jpwolfe9912/F722-FC-V3/PNGs/3D_Front.png

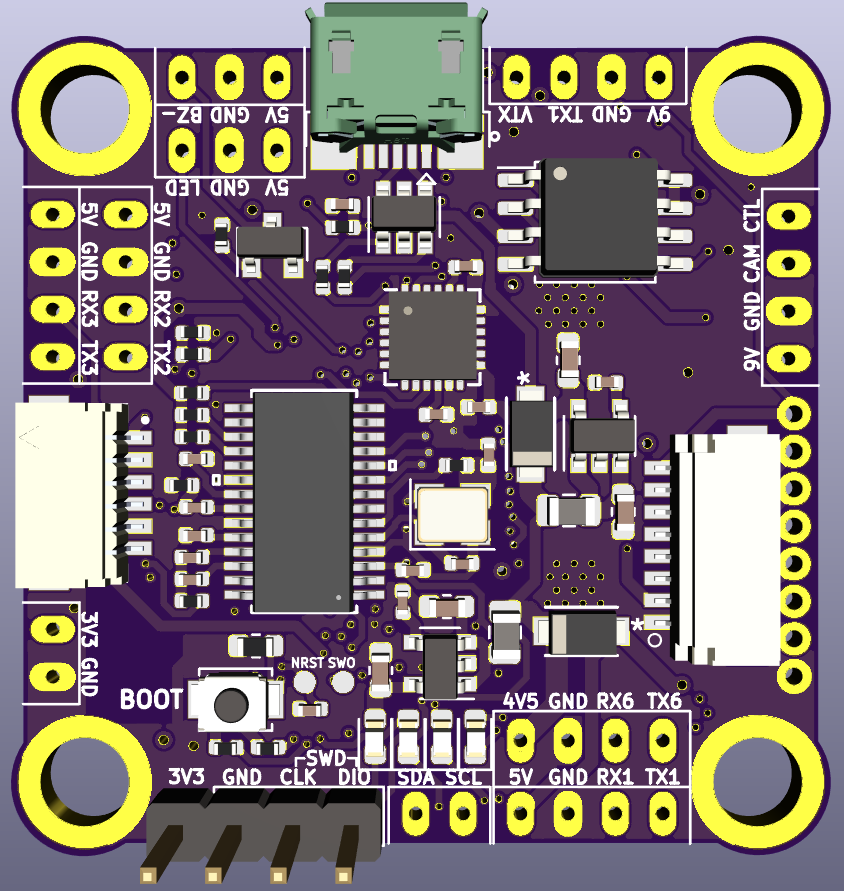
PNGs/3D_Front.png
