jpwolfe9912/F722-FC-V3/PNGs/3D_Back.png

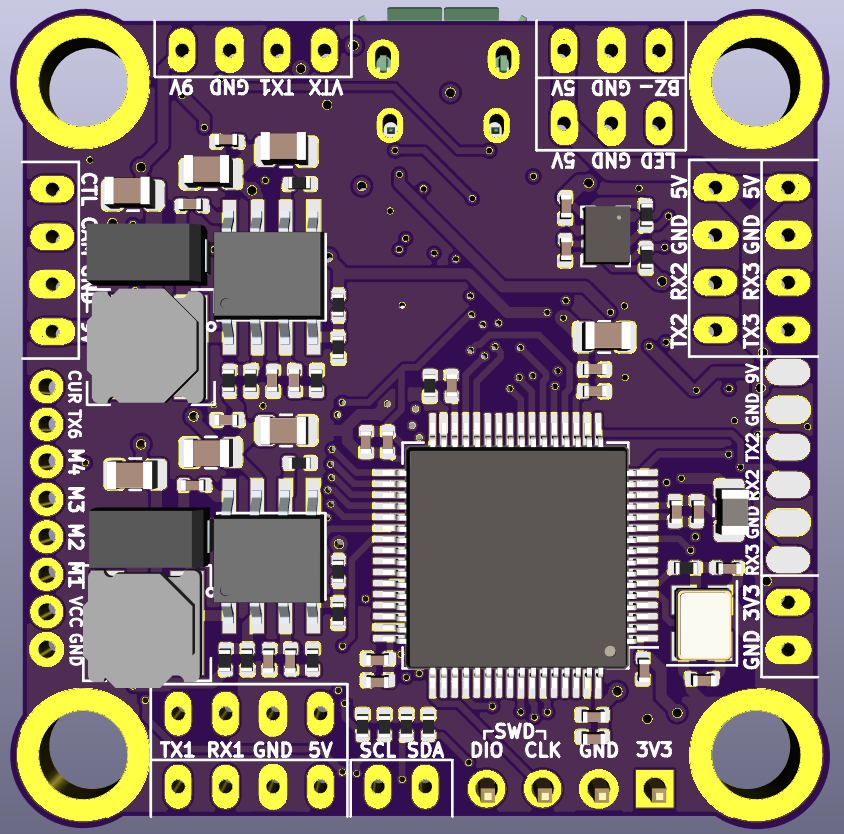
PNGs/3D_Back.png
