jpwolfe9912/F722-FC-V3/README.md

# F722-FC-V3

3D_Front
