jpwolfe9912/F722-FC-V3/PNGs/Design.png

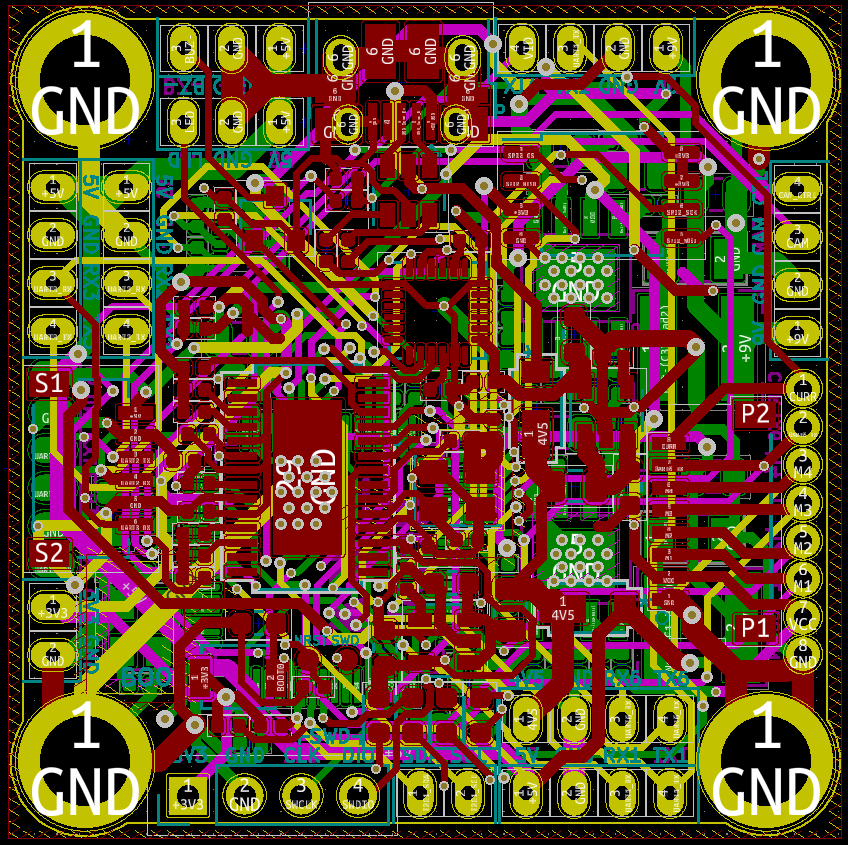
PNGs/Design.png
