jpwolfe9912/F722-FC-V3/PNGs/Schematic.png

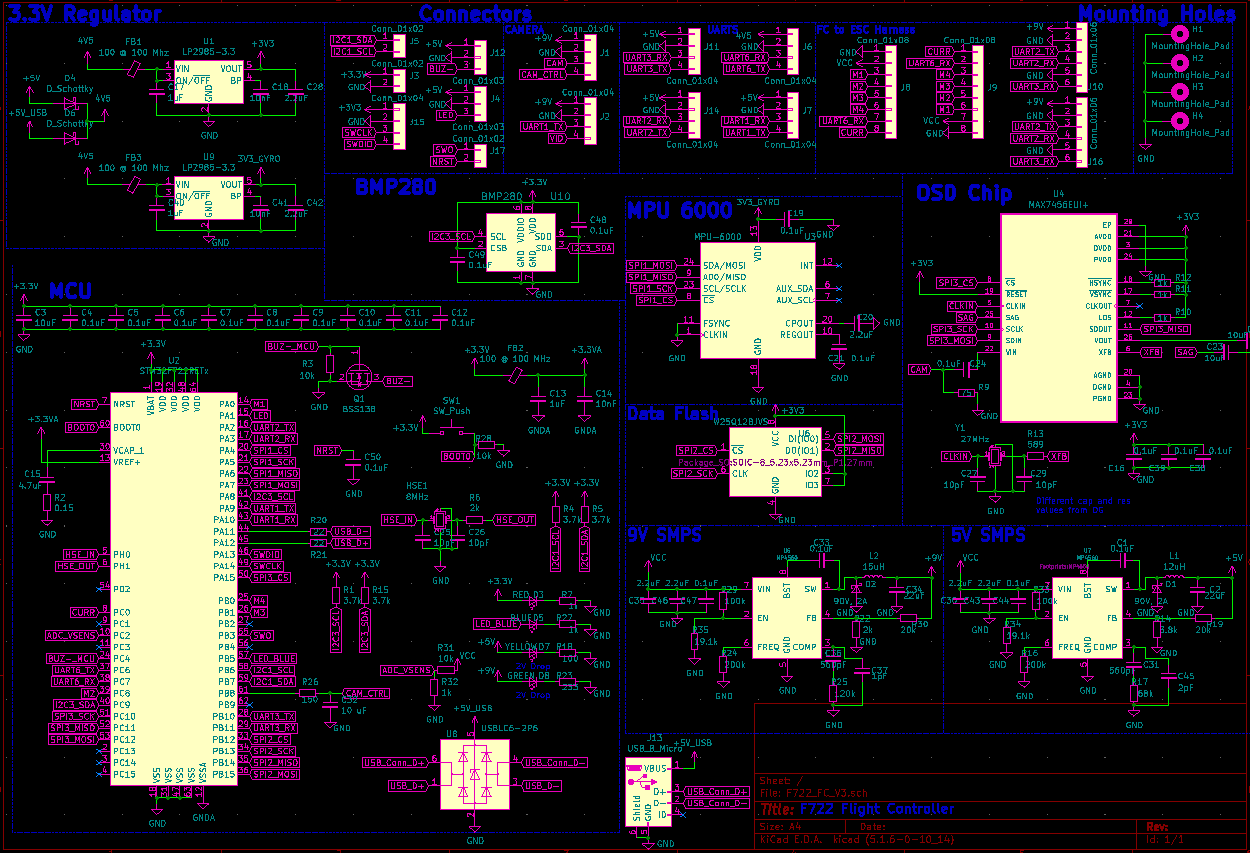
PNGs/Schematic.png
