jpwolfe9912/F722-FC-V3/F722_FC_V3.kicad_pcb

## KiCad design F722_FC_V3.kicad_pcb (2021-03-15)

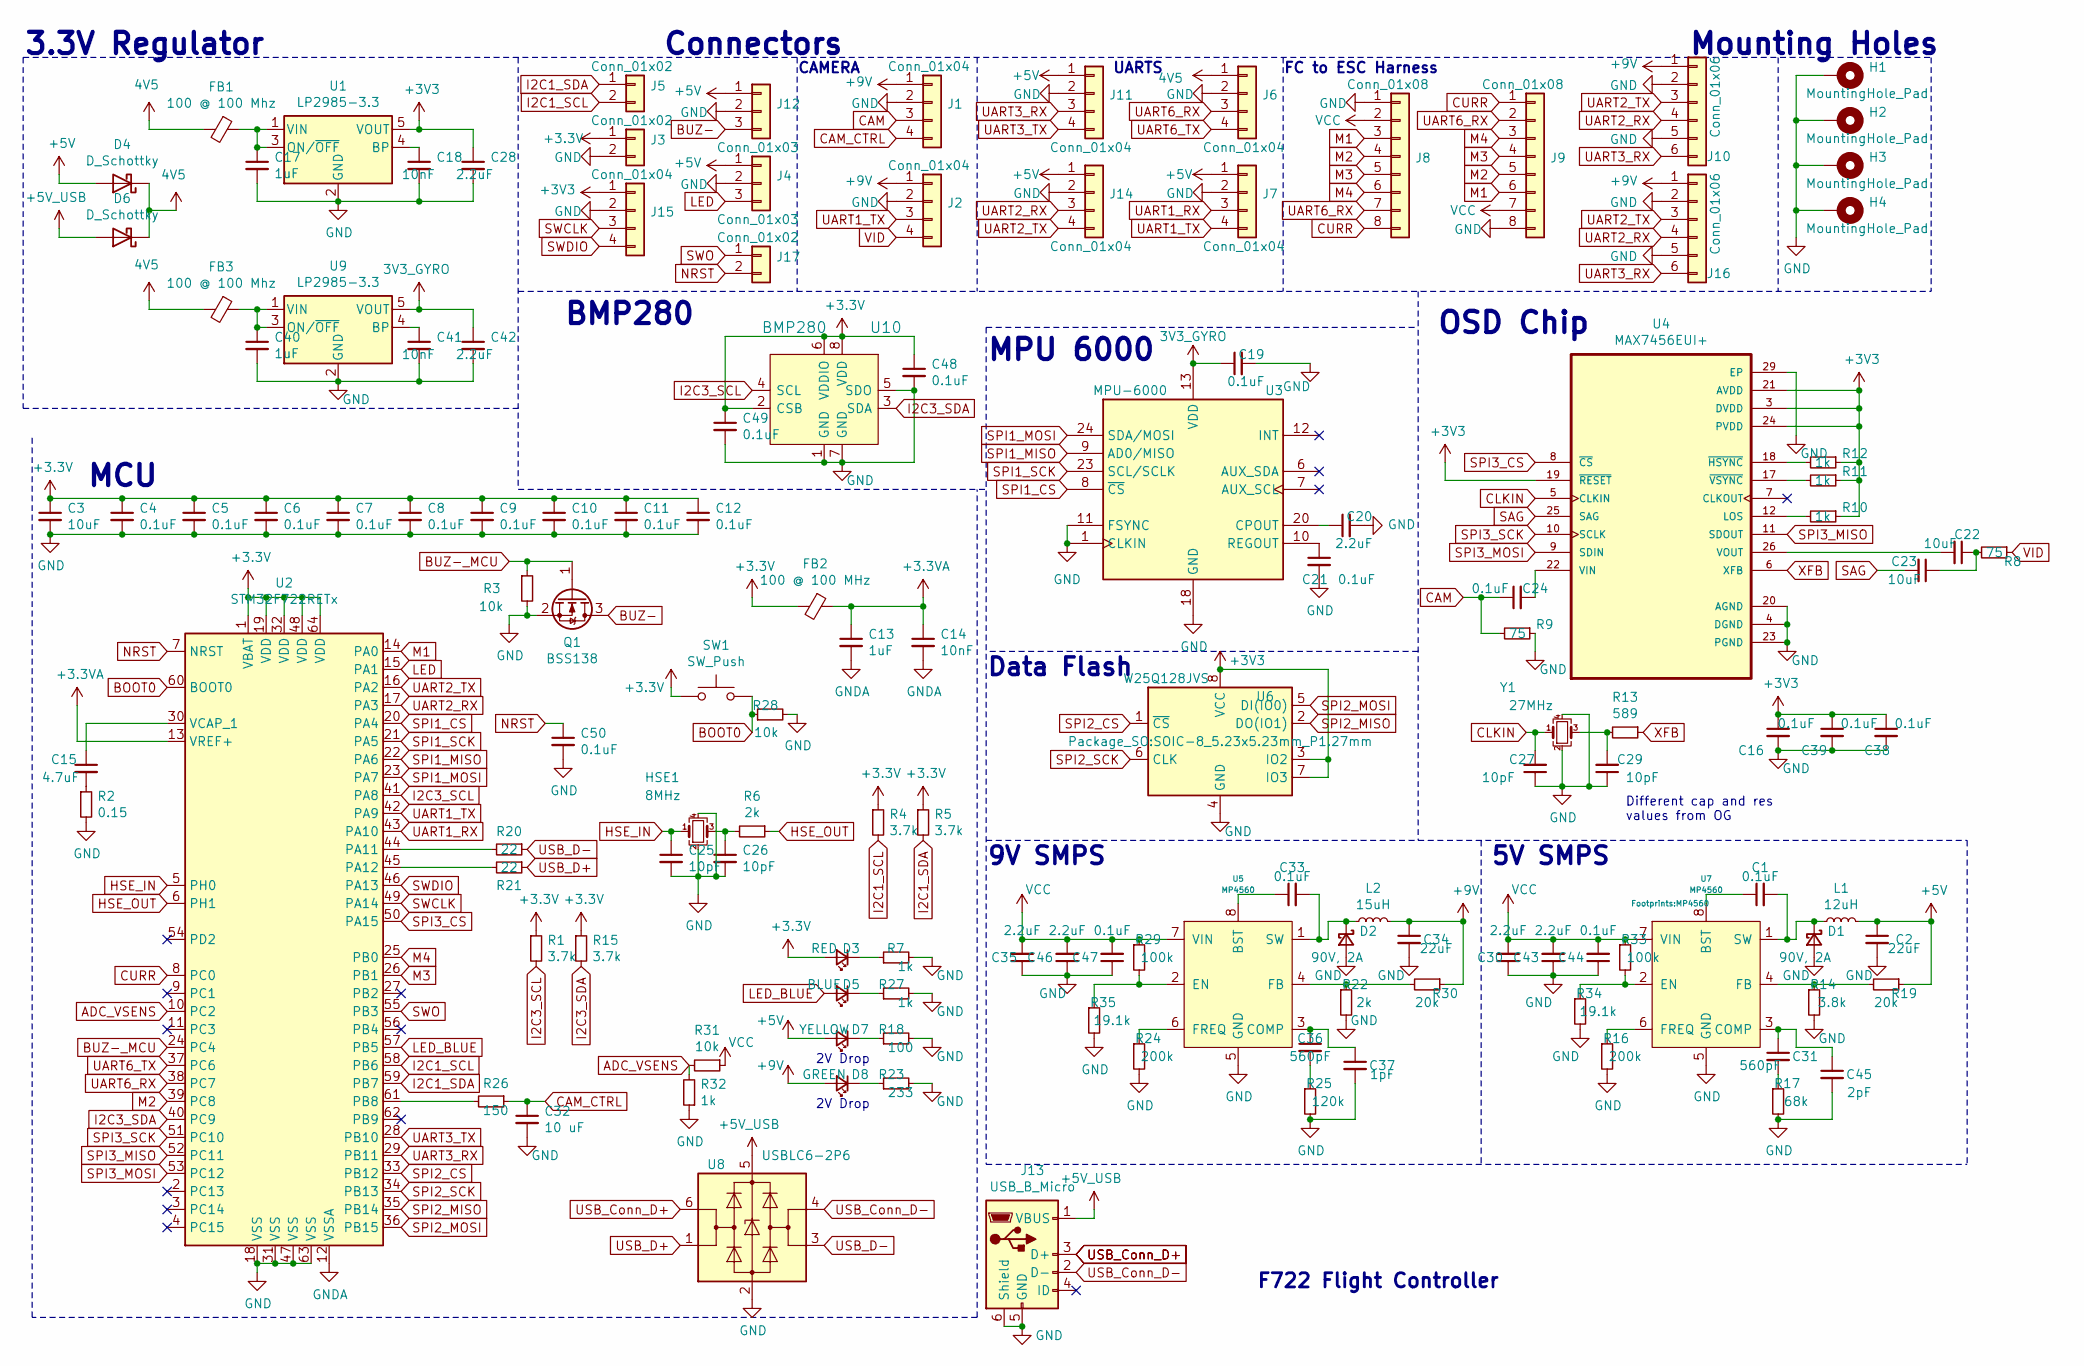
[picture p5: schematic F722_FC_V3.sch]

Parts:
C1, C4, C5, C6, C7, C8, C9, C10, C11, C12, C16, C19, C21, C24, C33, C38, C39, C44, C47, C48, C49, C50: 0.1uF; C_0402_1005Metric
C2, C34: 22uF; C_0805_2012Metric
C3: 10uF; C_0805_2012Metric
C13: 1uF; C_0402_1005Metric
C14, C18, C41: 10nF; C_0402_1005Metric
C15: 4.7uF; C_0402_1005Metric
C17, C40: 1uF; C_0603_1608Metric
C20: 2.2uF; C_0402_1005Metric
C22, C23: 10uF; C_0402_1005Metric
C25, C26, C27, C29: 10pF; C_0402_1005Metric
C28, C42: 2.2uF; C_0603_1608Metric
C30, C35, C43, C46: 2.2uF; C_0805_2012Metric
C31, C36: 560pF; C_0402_1005Metric
C32: 10 uF; C_0402_1005Metric
C37: 1pF; C_0402_1005Metric
C45: 2pF; C_0402_1005Metric
D1, D2: 90V, 2A; CDBMT2100-HF
D3: RED; LED_0603_1608Metric
D4, D6: D_Schottky; SBR3U30P1-7
D5: BLUE; LED_0603_1608Metric
D7: YELLOW; LED_0603_1608Metric
D8: GREEN; LED_0603_1608Metric
FB1, FB3: 100 @ 100 Mhz; L_0805_2012Metric
FB2: 100 @ 100 MHz; L_0805_2012Metric
H1, H2, H3, H4: MountingHole_Pad; MountingHole_2.7mm_Pad
HSE1: 8MHz; Oscillator_SMD_Abracon_ASE-4Pin_3.2x2.5mm
J1, J2, J6, J7, J11, J14: Conn_01x04; SolderWire-0.1sqmm_1x04_P3.6mm_D0.4mm_OD1mm
J3, J5, J17: Conn_01x02; SolderWire-0.1sqmm_1x02_P3.6mm_D0.4mm_OD1mm
J4, J12: Conn_01x03; SolderWire-0.1sqmm_1x03_P3.6mm_D0.4mm_OD1mm
J8: Conn_01x08; JST_SM08B-SRSS-TB(LF)(SN)
J9: Conn_01x08; SolderWire-0.1sqmm_1x08_D0.4mm_OD1mm
J10: Conn_01x06; JST_SM06B-SRSS-TB(LF)(SN)
J13: USB_B_Micro; USB_Micro-B_Amphenol_10103594-0001LF_Horizontal
J15: Conn_01x04; PinHeader_1x04_P2.54mm_Vertical
J16: Conn_01x06; Connector_Wire_Solder_DJI
L1: 12uH; L_Bourns-SRN5020
L2: 15uH; L_Bourns-SRN5020
Q1: BSS138; SOT-23
R1, R4, R5, R15: 3.7k; R_0402_1005Metric
R2: 0.15; R_0402_1005Metric
R3, R31: 10k; R_0402_1005Metric
R6, R22: 2k; R_0402_1005Metric
R7, R10, R11, R12, R27, R32: 1k; R_0402_1005Metric
R8, R9: 75; R_0402_1005Metric
R13: 589; R_0402_1005Metric
R14: 3.8k; R_0402_1005Metric
R16, R24: 200k; R_0402_1005Metric
R17: 68k; R_0402_1005Metric
R18: 100; R_0402_1005Metric
R19, R30: 20k; R_0402_1005Metric
R20, R21: 22; R_0402_1005Metric
R23: 233; R_0402_1005Metric
R25: 120k; R_0402_1005Metric
R26: 150; R_0402_1005Metric
R28: 10k; R_0603_1608Metric
R29, R33: 100k; R_0402_1005Metric
R34, R35: 19.1k; R_0402_1005Metric
SW1: SW_Push; SW_SPST_B3U-1000P
U1, U9: LP2985-3.3; SOT-23-5
U2: STM32F722RETx; LQFP-64_10x10mm_P0.5mm
U3: MPU-6000; InvenSense_QFN-24_4x4mm_P0.5mm
U4: MAX7456EUI+; MAX7456EUI&plus_T
U5, U7: MP4560
U6: W25Q128JVS; SOIC-8_5.23x5.23mm_P1.27mm
U8: USBLC6-2P6; SOT-23-6
U10: BMP280; Bosch_LGA-8_2x2.5mm_P0.65mm_ClockwisePinNumbering; MPN BMP280; Digi-Key_PN 828-1064-1-ND
Y1: 27MHz; Oscillator_SMD_Abracon_ASE-4Pin_3.2x2.5mm

Connections:
4V5: D4.1 (K), D6.1 (K), FB1.2, FB3.2, J6.1
+3.3VA: C13.1, C14.1, FB2.1, U2.13 (VREF+)
+3V3_GYRO: C19.1, C42.1, U3.13 (VDD), U9.5 (VOUT)
+5V: C2.1, D4.2 (A), D7.2 (A), J4.1, J7.1, J11.1, J12.1, J14.1, L1.2, R19.1
+5V_USB: D6.2 (A), J13.1 (VBUS), U8.5 (VBUS)
+9V: C34.1, D8.2 (A), J1.1, J2.1, J10.1, J16.1, L2.2, R30.1
ADC_VSENS: R31.2, R32.2, U2.10 (PC2)
BOOT0: R28.1, SW1.2, U2.60 (BOOT0)
BUZ-: J12.3, Q1.3 (D)
BUZ-_MCU: Q1.1 (G), R3.1, U2.24 (PC4)
CAM: C24.1, J1.3, R9.2
CAM_CTRL: C32.1, J1.4, R26.1
CLKIN: C27.2, U4.5 (CLKIN), Y1.1
CURR: J8.8, J9.1, U2.8 (PC0)
GND: C2.2, C3.2, C4.2, C5.2, C6.2, C7.2, C8.2, C9.2, C10.2, C11.2, C12.2, C16.2, C17.2, C18.2, C19.2, C20.2, C21.2, C25.2, C26.2, C27.1, C28.2, C29.1, C30.1, C32.2, C34.2, C35.1, C37.2, C38.2, C39.2, C40.2, C41.2, C42.2, C43.1, C44.1, C45.2, C46.1, C47.1, C48.2, C49.2, C50.2, D1.2 (A), D2.2 (A), H1.1, H2.1, H3.1, H4.1, HSE1.2, HSE1.4, J1.2, J2.2, J3.2, J4.2, J6.2, J7.2, J8.1, J9.8, J10.2, J10.5, J11.2, J12.2, J13.5 (GND), J13.6 (Shield), J14.2, J15.2, J16.2, J16.5, Q1.2 (S), R2.2, R3.2, R7.2, R9.1, R14.2, R16.2, R17.2, R18.2, R22.2, R23.2, R24.2, R25.2, R27.2, R28.2, R32.1, R34.2, R35.2, U1.2 (GND), U2.18 (VSS), U2.31 (VSS), U2.47 (VSS), U2.63 (VSS), U3.1 (CLKIN), U3.11 (FSYNC), U3.18 (GND), U4.4 (DGND), U4.20 (AGND), U4.23 (PGND), U4.29 (EP), U5.5 (GND), U6.4 (GND), U7.5 (GND), U8.2 (GND), U9.2 (GND), U10.1 (GND), U10.5 (SDO), U10.7 (GND), Y1.2, Y1.4
GNDA: C13.2, C14.2, U2.12 (VSSA)
HSE_IN: C25.1, HSE1.1, U2.5 (PH0)
HSE_OUT: R6.1, U2.6 (PH1)
I2C1_SCL: J5.2, R4.2, U2.58 (PB6)
I2C1_SDA: J5.1, R5.2, U2.59 (PB7)
I2C3_SCL: R1.2, U2.41 (PA8), U10.4 (SCL)
I2C3_SDA: R15.2, U2.40 (PC9), U10.3 (SDA)
LED: J4.3, U2.15 (PA1)
LED_BLUE: D5.2 (A), U2.57 (PB5)
M1: J8.3, J9.6, U2.14 (PA0)
M2: J8.4, J9.5, U2.39 (PC8)
M3: J8.5, J9.4, U2.26 (PB1)
M4: J8.6, J9.3, U2.25 (PB0)
NRST: C50.1, J17.2, U2.7 (NRST)
unnamed: C1.1, U7.8 (BST)
unnamed: C1.2, D1.1 (K), L1.1, U7.1 (SW)
unnamed: C15.1, U2.30 (VCAP_1)
unnamed: C15.2, R2.1
unnamed: C17.1, FB1.1, U1.1 (VIN), U1.3 (ON/~OFF~)
unnamed: C18.1, U1.4 (BP)
unnamed: C20.1, U3.20 (CPOUT)
unnamed: C21.1, U3.10 (REGOUT)
unnamed: C22.1, C23.1, R8.2
unnamed: C22.2, U4.26 (VOUT)
unnamed: C24.2, U4.22 (VIN)
unnamed: C26.1, HSE1.3, R6.2
unnamed: C29.2, R13.2, Y1.3
unnamed: C31.1, C45.1, U7.3 (COMP)
unnamed: C31.2, R17.1
unnamed: C33.1, U5.8 (BST)
unnamed: C33.2, D2.1 (K), L2.1, U5.1 (SW)
unnamed: C36.1, C37.1, U5.3 (COMP)
unnamed: C36.2, R25.1
unnamed: C40.1, FB3.1, U9.1 (VIN), U9.3 (ON/~OFF~)
unnamed: C41.1, U9.4 (BP)
unnamed: D3.1 (K), R7.1
unnamed: D5.1 (K), R27.1
unnamed: D7.1 (K), R18.1
unnamed: D8.1 (K), R23.1
unnamed: R10.2, U4.12 (LOS)
unnamed: R11.2, U4.17 (~VSYNC)
unnamed: R12.2, U4.18 (~HSYNC)
unnamed: R14.1, R19.2, U7.4 (FB)
unnamed: R16.1, U7.6 (FREQ)
unnamed: R20.2, U2.44 (PA11)
unnamed: R21.2, U2.45 (PA12)
unnamed: R22.1, R30.2, U5.4 (FB)
unnamed: R24.1, U5.6 (FREQ)
unnamed: R26.2, U2.61 (PB8)
unnamed: R29.2, R35.1, U5.2 (EN)
unnamed: R33.2, R34.1, U7.2 (EN)
SAG: C23.2, U4.25 (SAG)
SPI1_CS: U2.20 (PA4), U3.8 (~CS)
SPI1_MISO: U2.22 (PA6), U3.9 (AD0/MISO)
SPI1_MOSI: U2.23 (PA7), U3.24 (SDA/MOSI)
SPI1_SCK: U2.21 (PA5), U3.23 (SCL/SCLK)
SPI2_CS: U2.33 (PB12), U6.1 (~CS)
SPI2_MISO: U2.35 (PB14), U6.2 (DO(IO1))
SPI2_MOSI: U2.36 (PB15), U6.5 (DI(IO0))
SPI2_SCK: U2.34 (PB13), U6.6 (CLK)
SPI3_CS: U2.50 (PA15), U4.8 (~CS)
SPI3_MISO: U2.52 (PC11), U4.11 (SDOUT)
SPI3_MOSI: U2.53 (PC12), U4.9 (SDIN)
SPI3_SCK: U2.51 (PC10), U4.10 (SCLK)
SWCLK: J15.3, U2.49 (PA14)
SWDIO: J15.4, U2.46 (PA13)
SWO: J17.1, U2.55 (PB3)
UART1_RX: J7.3, U2.43 (PA10)
UART1_TX: J2.3, J7.4, U2.42 (PA9)
UART2_RX: J10.4, J14.3, J16.4, U2.17 (PA3)
UART2_TX: J10.3, J14.4, J16.3, U2.16 (PA2)
UART3_RX: J10.6, J11.3, J16.6, U2.29 (PB11)
UART3_TX: J11.4, U2.28 (PB10)
UART6_RX: J6.3, J8.7, J9.2, U2.38 (PC7)
UART6_TX: J6.4, U2.37 (PC6)
USB_Conn_D+: J13.3 (D+), U8.6 (I/O1)
USB_Conn_D-: J13.2 (D-), U8.4 (I/O2)
USB_D+: R21.1, U8.1 (I/O1)
USB_D-: R20.1, U8.3 (I/O2)
VCC: C30.2, C35.2, C43.2, C44.2, C46.2, C47.2, J8.2, J9.7, R29.1, R31.1, R33.1, U5.7 (VIN), U7.7 (VIN)
VID: J2.4, R8.1
XFB: R13.1, U4.6 (XFB)

Notes on the sheet:
3.3V Regulator
MCU
Mounting Holes
F722 Flight Controller
MPU 6000
FC to ESC Harness
UARTS
Connectors
CAMERA
5V SMPS
9V SMPS
Data Flash
Different cap and res values from OG
OSD Chip
BMP280
2V Drop

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
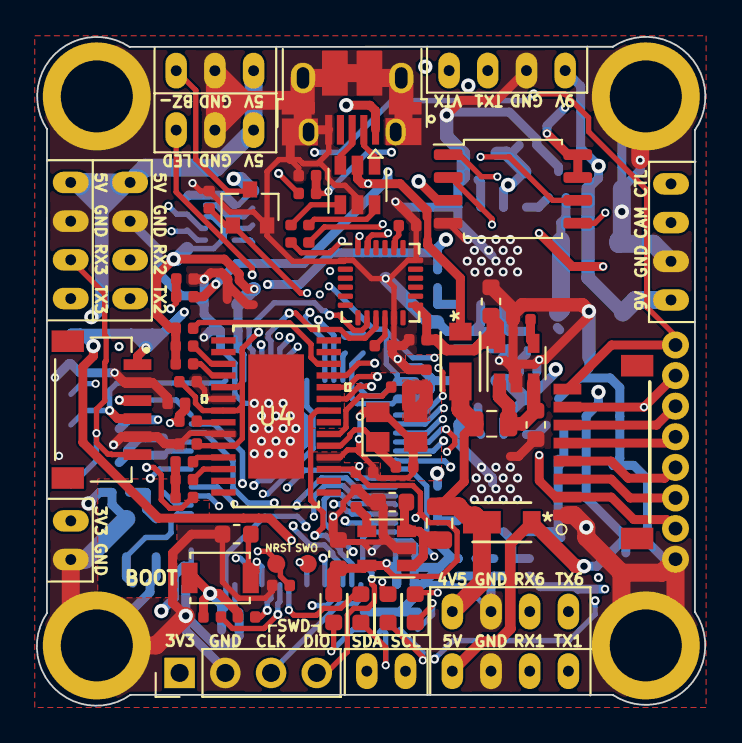
[picture p6: board F722_FC_V3.kicad_pcb from above]

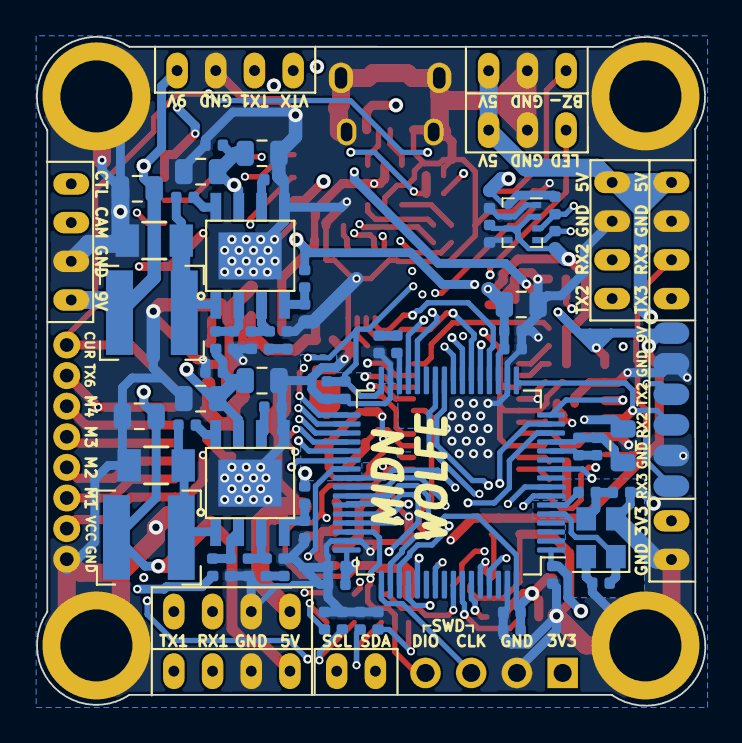
[picture p7: board F722_FC_V3.kicad_pcb from below]

Board: 4 copper layers, 37.1 x 37.2 mm, 133 parts (62 on the bottom side), 98 nets.
